joshuathomascarter/MNIST-Accel/docs/figs/carla_town05_junction_demo.png

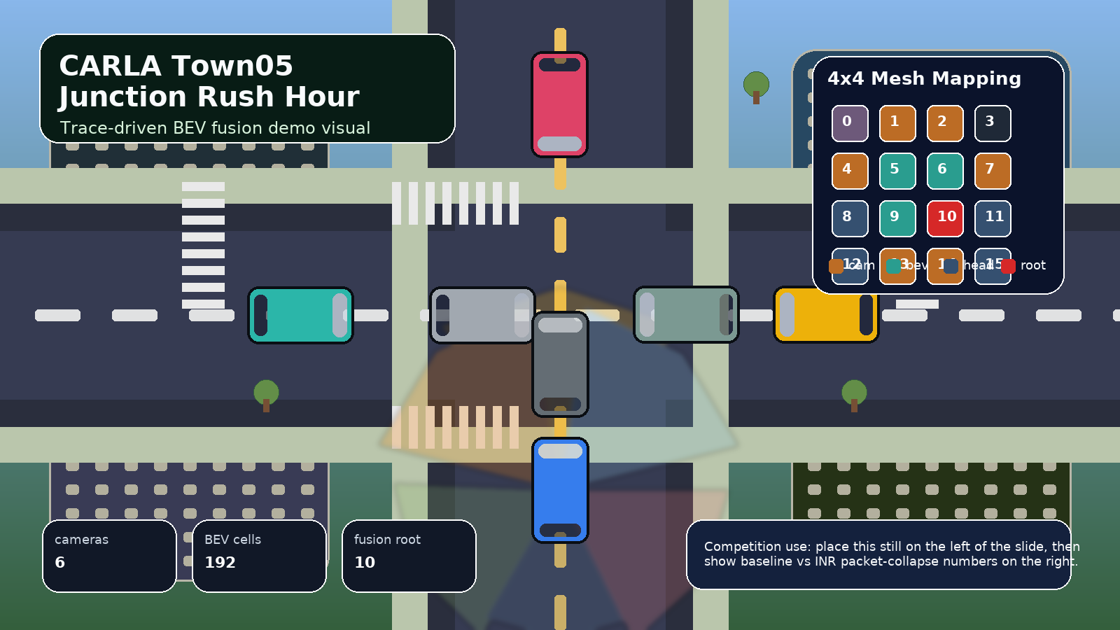
docs/figs/carla_town05_junction_demo.png
