joshuathomascarter/MNIST-Accel/docs/figs/carla_town05_junction_hero.png

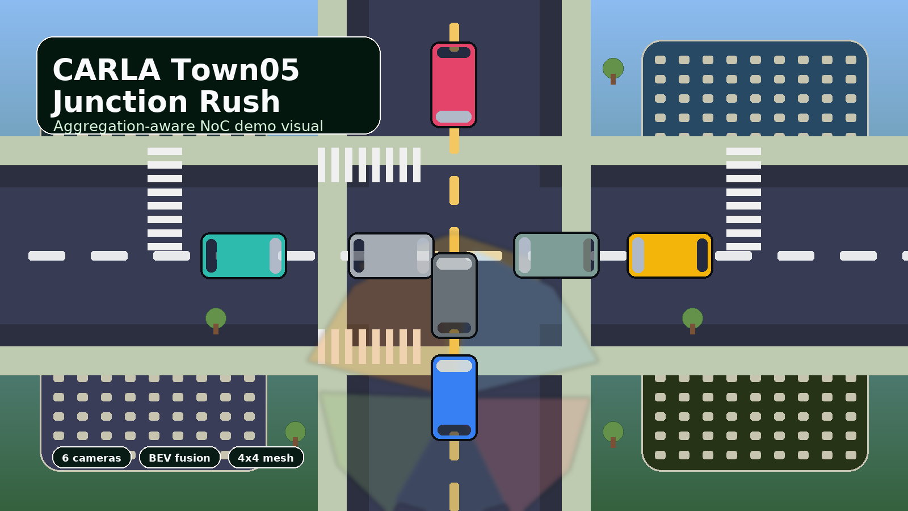
docs/figs/carla_town05_junction_hero.png
