joshuathomascarter/MNIST-Accel/archive/old_project_done/README.md

# Old Project Archive

This directory snapshots the legacy host-side FPGA software stack that is no
longer part of the active `soc_top_v2` bringup path.

## Included

- `sw/ml_python/host/`
- `sw/cpp/include/{driver,memory,compute}/`
- `sw/cpp/src/{driver,memory,compute}/`
- `sw/cpp/apps/{benchmark.cpp,run_mnist_inference.cpp}`

Use this archive as reference only. Active bringup artifacts now live under
`handoff/soc_top_v2/`.
