joshuathomascarter/MNIST-Accel/docs/figs/carla_town05_junction_annotated.png

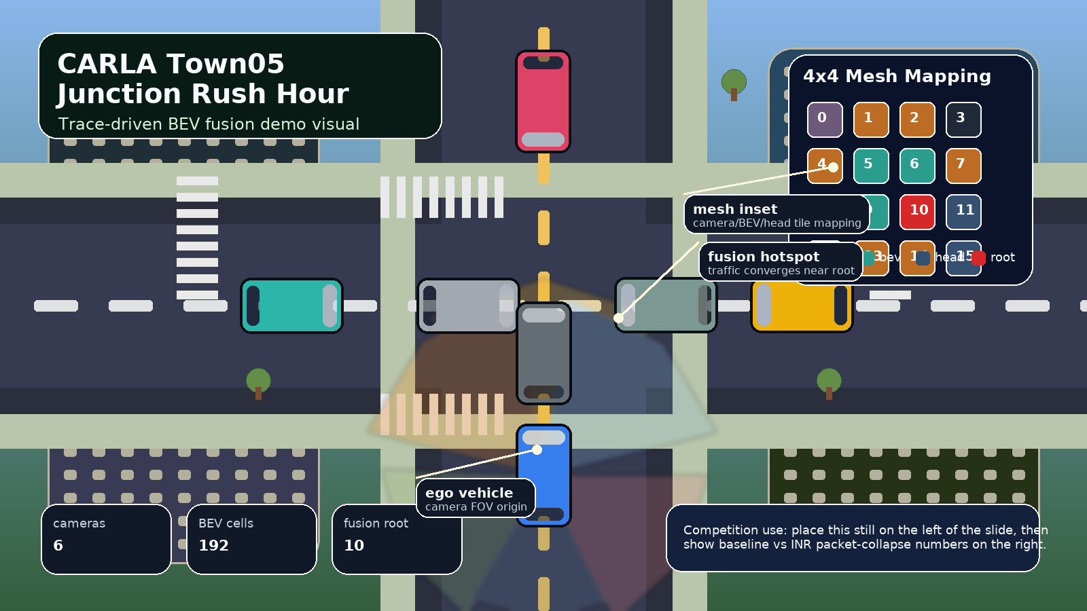
docs/figs/carla_town05_junction_annotated.png
