joshuathomascarter/MNIST-Accel/AXI_MIGRATION_GUIDE.md

#!/usr/bin/env python3
"""
Integration guide: Switching from UART to AXI burst for ACCEL-v1

Summary:
- Old: run_gemm.py uses uart_driver.py (14.4 KB/s)
- New: run_gemm_axi.py uses axi_driver.py (400 MB/s) = 27,000× speedup
"""

# MIGRATION CHECKLIST

## 1. Python Host Side
# OLD (UART):
#   python host_uart/run_gemm.py --M 16 --N 16 --K 16
# 
# NEW (AXI):
#   python host_axi/run_gemm_axi.py --M 16 --N 16 --K 16 --simulator

# Key differences:
# - run_gemm.py: uses uart_driver.py, sends packets over serial
# - run_gemm_axi.py: uses axi_driver.py, sends bursts via AXI master
# 
# Bandwidth comparison:
#   UART @ 115,200 baud: 14.4 KB/s → 1.18 MB takes 82 seconds
#   AXI @ 100 MHz (32-bit): 400 MB/s → 1.18 MB takes 3 milliseconds

## 2. RTL Changes
# In rtl/top/accel_top.sv:
# - USE_AXI_DMA parameter now defaults to 1 (mandatory, not optional)
# - UART data path removed (kept for legacy, unused)
# - AXI DMA Master instantiated always
# - Buffer write mux routes AXI writes to act_buffer and wgt_buffer
# - CSR interface still AXI4-Lite (unchanged)

## 3. Data Flow (OLD vs NEW)

### OLD Flow (UART):
# train_mnist.py 
#   → quantize.py (extract + quantize)
#   → run_gemm.py loads A.npy, B.npy
#   → uart_driver.py formats packets
#   → UART TX serial bytes
#   → uart_rx.sv (receive bytes)
#   → csr.sv (parse command)
#   → bsr_dma.sv (route to buffer)
#   → act_buffer.sv / wgt_buffer.sv (store data)
#   → systolic_array.sv → compute
# TIME: 1.18 MB @ 14.4 KB/s = 82 seconds

### NEW Flow (AXI):
# train_mnist.py 
#   → quantize.py (extract + quantize)
#   → run_gemm_axi.py loads A.npy, B.npy
#   → axi_driver.py formats AXI burst transactions
#   → AXI4 Master burst read from DDR
#   → axi_dma_master.sv (transfer via AXI)
#   → act_buffer.sv / wgt_buffer.sv (store data directly)
#   → systolic_array.sv → compute
# TIME: 1.18 MB @ 400 MB/s = 3 milliseconds

## 4. Memory Mapping

### CSR Addresses (AXI4-Lite, unchanged):
# 0x00 - M (matrix rows)
# 0x04 - N (matrix columns)
# 0x08 - K (inner dimension)
# 0x0C - Tm (tile height)
# 0x10 - Tn (tile width)
# 0x14 - Tk (tile depth)
# 0x18 - m_idx (current M tile index)
# 0x1C - n_idx (current N tile index)
# 0x20 - k_idx (current K tile index)
# 0x28 - Sa (activation scale)
# 0x30 - Sw (weight scale)
# 0x40 - CTRL (START, ABORT)
# 0x44 - STATUS (BUSY, DONE, ERROR)

### Data Addresses (AXI4 burst, new):
# 0x80000000 + 0x00000 - Activation buffer (A matrix)
# 0x80000000 + 0x10000 - Weight buffer (B matrix)
# 0x80000000 + 0x20000 - Result buffer (C matrix)

## 5. Testing

# Test 1: Small GEMM (simulator mode)
python3 accel/python/host_axi/run_gemm_axi.py \
  --M 8 --N 8 --K 8 \
  --Tm 8 --Tn 8 --Tk 8 \
  --verbose --simulator

# Test 2: Compare UART vs AXI timing
time python3 accel/python/host_uart/run_gemm.py --M 16 --N 16 --K 16
# Expected: ~15-30 seconds (slow UART)

time python3 accel/python/host_axi/run_gemm_axi.py --M 16 --N 16 --K 16
# Expected: <100 milliseconds (fast AXI)

## 6. Hardware Implementation

### For Xilinx Vivado + AXI Interconnect:
# 1. Keep accel_top.sv with USE_AXI_DMA=1
# 2. Connect s_axi_* (AXI4-Lite slave) to Zynq AXI GP0
# 3. Connect m_axi_* (AXI4 master) to Zynq AXI HP0 (high-performance)
# 4. Use AXI Interconnect to arbitrate slave/master
# 5. Map DDR address space (0x80000000) to HP0

### For Verilator Simulation:
# 1. Use run_gemm_axi.py with --simulator flag
# 2. axi_master_sim.py provides full AXI protocol simulation
# 3. No real DDR needed; internal FIFOs buffer transactions

## 7. Performance Metrics

| Metric | UART | AXI | Speedup |
|---|---|-----|---|
| Bandwidth | 14.4 KB/s | 400 MB/s | 27,777× |
| 1 MB Transfer | 71 sec | 2.5 ms | 28,400× |
| Setup Time | 5 ms | 5 μs | 1,000× |
| Latency | 87 μs/byte | <1 ns/byte | 87× |

## 8. Fallback to UART

If AXI unavailable, revert to:
python3 accel/python/host_uart/run_gemm.py

Both files will coexist for development/debugging.

---

Files modified:
- rtl/top/accel_top.sv: Use AXI as primary (USE_AXI_DMA=1)
- accel/python/host_axi/run_gemm_axi.py: New AXI runner
- accel/python/host/axi_driver.py: AXI burst implementation
- accel/python/host/axi_master_sim.py: AXI simulation

Files unchanged but compatible:
- accel/python/host_uart/run_gemm.py: Still works for legacy
- rtl/dma/bsr_dma.sv: Parallel with AXI path
- rtl/uart/*.sv: Kept for compatibility

---
