joshuathomascarter/MNIST-Accel/hw/.yosys_soc_top_v2/all/rtl/top/accel_top.sv

// =============================================================================
// accel_top.sv — AXI4-based Sparse INT8 Systolic Array Accelerator Top-Level
// =============================================================================
//
// ARCHITECTURE OVERVIEW:
// ----------------------
// This is the top-level integration module for a sparse INT8 matrix multiply
// accelerator targeting Zynq-7020 (PYNQ-Z2). It implements a weight-stationary
// dataflow with Block Sparse Row (BSR) compression for weight matrices.
//
//   ┌─────────────────────────────────────────────────────────────────────┐
//   │                         Zynq PS (ARM Cortex-A9)                     │
//   │                                                                     │
//   │   Linux Driver                                                      │
//   │       │                                                             │
//   │       ├── AXI-Lite GP0 ─────────────────┐                          │
//   │       │   (CSR R/W)                     │                          │
//   │       │                                 │                          │
//   │       └── mmap DDR ──────────────┐      │                          │
//   │           (Activations, Weights) │      │                          │
//   └───────────────────────────────────┼──────┼──────────────────────────┘
//                                       │      │
//   ┌───────────────────────────────────┼──────┼──────────────────────────┐
//   │                            PL (FPGA Fabric)                         │
//   │                                   │      │                          │
//   │   ┌───────────────────────────────┼──────▼──────┐                  │
//   │   │            AXI Interconnect                 │                  │
//   │   └───────────┬───────────────────┬─────────────┘                  │
//   │               │                   │                                 │
//   │     AXI4 HP0/HP2                 AXI-Lite                          │
//   │     (64-bit DDR)                 (32-bit CSR)                      │
//   │               │                   │                                 │
//   │   ┌───────────▼───────────┐   ┌───▼────────────┐                   │
//   │   │   axi_dma_bridge      │   │ axi_lite_slave │                   │
//   │   │   (2:1 Arbiter)       │   └───────┬────────┘                   │
//   │   └───┬───────────────┬───┘           │                            │
//   │       │               │               │                            │
//   │   ┌───▼───┐       ┌───▼───┐       ┌───▼───┐                        │
//   │   │act_dma│       │bsr_dma│       │  csr  │                        │
//   │   └───┬───┘       └───┬───┘       └───────┘                        │
//   │       │               │                                             │
//   │   ┌───▼───┐       ┌───▼───────────────────┐                        │
//   │   │act_buf│       │ BSR Metadata BRAMs    │                        │
//   │   │ (RAM) │       │ (row_ptr, col_idx,    │                        │
//   │   └───┬───┘       │  wgt_block)           │                        │
//   │       │           └───┬───────────────────┘                        │
//   │       │               │                                             │
//   │       │           ┌───▼────────┐                                   │
//   │       │           │bsr_scheduler│                                    │
//   │       │           └───┬────────┘                                   │
//   │       │               │                                             │
//   │       │     ┌─────────▼─────────┐                                  │
//   │       └────►│ systolic_array    │                                  │
//   │             │ (16×16 PE Grid)   │                                  │
//   │             └─────────┬─────────┘                                  │
//   │                       │                                             │
//   │             ┌─────────▼─────────┐                                  │
//   │             │  Output / Accum   │─────► DMA back to DDR            │
//   │             └───────────────────┘       (future: write DMA)        │
//   │                                                                     │
//   │             ┌───────────────────┐                                  │
//   │             │       perf        │                                  │
//   │             │ (Cycle Counters)  │                                  │
//   │             └───────────────────┘                                  │
//   └─────────────────────────────────────────────────────────────────────┘
//
// DATA FLOW:
// ----------
// 1. Host writes configuration to CSR (matrix dims, DMA addresses)
// 2. Host triggers DMA start pulses:
//    - act_dma: Loads dense activations from DDR → act_buffer RAM
//    - bsr_dma: Loads BSR sparse weights from DDR → metadata BRAMs
// 3. Host triggers start_pulse to begin computation
// 4. bsr_scheduler iterates through non-zero blocks:
//    a. Reads row_ptr[i] and row_ptr[i+1] from BRAM (1-cycle latency)
//    b. For each column index, loads weight block and streams activations
//    c. Signals systolic array with load_weight, pe_en, accum_en
// 5. systolic_array_sparse performs 16×16 MAC operations
// 6. Results accumulate in output registers (visible via CSR)
// 7. done signal asserted when all blocks processed
//
// SPARSE FORMAT (BSR - Block Sparse Row):
// ---------------------------------------
// Memory layout for a matrix with M=32, K=32, block_size=16:
//   DDR Base + 0x00: num_rows (= M/16 = 2)
//   DDR Base + 0x04: num_cols (= K/16 = 2)
//   DDR Base + 0x08: nnz_blocks (number of non-zero 16×16 blocks)
//   DDR Base + 0x0C: block_size (= 16)
//   DDR Base + 0x10: row_ptr[0..num_rows] (32-bit each)
//   DDR Base + 0x10 + (num_rows+1)*4: col_idx[0..nnz_blocks-1] (16-bit each)
//   DDR Base + aligned: blocks[0..nnz_blocks-1] (256 bytes each)
//
// DESIGN CHOICES:
// ---------------
// - SPARSE-ONLY: Dense systolic array variant removed to save ~40% LUT area.
//   For dense layers (fc1, fc2), use 100% dense BSR (no zero blocks).
// - READ-ONLY DMAs: Outputs are read via CSR result registers. Write DMA
//   for large output tensors is a future enhancement.
// - BRAM Sizing: BRAM_ADDR_W=10 gives 1024 entries. With 16×16 blocks:
//   - row_ptr_bram: 1024 × 32-bit = 4 KB (supports up to 1023 block rows)
//   - col_idx_bram: 1024 × 16-bit = 2 KB (supports up to 1024 non-zero blocks)
//   - wgt_block_bram: 1024 × 64-bit = 8 KB (32 full blocks, but typically
//     only current block needs to be resident)
//
// TIMING CONSTRAINTS:
// -------------------
// Target: 100 MHz (10 ns period) on Zynq-7020
// Critical paths:
//   - AXI read data → BRAM write: 3 cycles (DMA FSM latency)
//   - Metadata BRAM read → scheduler: 2 cycles (read-after-write hazard)
//   - Scheduler → systolic array control: 1 cycle
//
// RESOURCE ESTIMATES (Zynq-7020):
// -------------------------------
//   Module            | LUTs  | FFs   | BRAM36 | DSPs
//   ------------------|-------|-------|--------|------
//   axi_lite_slave    |  200  |  150  |   0    |  0
//   csr               |  400  |  500  |   0    |  0
//   axi_dma_bridge    |  300  |  200  |   0    |  0
//   act_dma           |  250  |  180  |   0    |  0
//   bsr_dma           |  450  |  350  |   0    |  0
//   bsr_scheduler     |  350  |  280  |   0    |  0
//   systolic_sparse   | 4000  | 8000  |   0    | 256
//   BRAMs (inline)    |    0  |    0  |   4    |  0
//   perf              |  100  |  200  |   0    |  0
//   ------------------|-------|-------|--------|------
//   Total (approx)    | 6050  | 9850  |   4    | 256
//
// Zynq-7020 has 53,200 LUTs, 106,400 FFs, 140 BRAM36, 220 DSPs.
// This design uses ~12% LUTs, ~10% FFs, ~4% BRAM, ~100% DSPs.
//
// VERIFICATION:
// -------------
// - Cocotb testbench: hw/sim/cocotb/test_accel_top.py
// - C++ testbench: hw/sim/cpp/accel_top_tb.cpp
// - Waveform: Run with +wave=accel_top.vcd
//
// INTEGRATION:
// ------------
// Vivado block design connections:
//   - clk: pl_clk0 (100 MHz from FCLK_CLK0)
//   - rst_n: peripheral_aresetn from proc_sys_reset
//   - m_axi_*: HP0 or HP2 port of Zynq PS
//   - s_axi_*: M_AXI_GP0 through AXI Interconnect
//
// =============================================================================

`timescale 1ns/1ps
`default_nettype none

module accel_top #(
/* verilator lint_off PINCONNECTEMPTY */
    // =========================================================================
    // SYSTOLIC ARRAY PARAMETERS
    // =========================================================================
    // N_ROWS, N_COLS: Systolic array dimensions.
    // - 16×16 systolic array (256 PEs)
    // - Matches BSR block size for efficient weight loading
    parameter N_ROWS     = 16,
    parameter N_COLS     = 16,
    
    // DATA_W: Input data width (INT8 for quantized inference)
    // - INT8 provides 2× throughput vs INT16, 4× vs FP32
    // - Sufficient precision for CNN inference (< 1% accuracy loss)
    parameter DATA_W     = 8,
    
    // ACC_W: Accumulator width to prevent overflow
    // - 8-bit × 8-bit = 16-bit product
    // - Sum of K products: need log2(K) + 16 bits
    // - For K=512 (max), need 16 + 9 = 25 bits minimum
    // - 32 bits provides headroom for larger layers
    parameter ACC_W      = 32,
    
    // =========================================================================
    // AXI INTERFACE PARAMETERS
    // =========================================================================
    // AXI_ADDR_W: 32-bit addresses for Zynq DDR (512 MB - 1 GB range)
    parameter AXI_ADDR_W = 32,
    
    // AXI_DATA_W: 64-bit for HP port bandwidth
    // - Zynq HP ports are 64-bit native
    // - 8 INT8 values per beat × 16 beats = 128 bytes/burst
    parameter AXI_DATA_W = 64,
    
    // AXI_ID_W: Transaction ID for out-of-order completion tracking
    // - 4 bits = 16 outstanding transactions (more than needed)
    // - ID=0 for BSR DMA, ID=1 for Act DMA
    parameter AXI_ID_W   = 4,
    
    // =========================================================================
    // INTERNAL MEMORY PARAMETERS
    // =========================================================================
    // CSR_ADDR_W: 8-bit CSR address (256 registers × 4 bytes = 1 KB)
    // - Matches Vivado AXI peripheral standard address range
    parameter CSR_ADDR_W = 8,
    
    // BRAM_ADDR_W: 10-bit BRAM address (1024 entries)
    // - row_ptr: 1024 × 4B = 4 KB (up to 1023 block rows)
    // - col_idx: 1024 × 2B = 2 KB (up to 1024 non-zero blocks)
    // - wgt_block: 1024 × 8B = 8 KB (block data staging)
    parameter BRAM_ADDR_W = 10
)(
    // =========================================================================
    // Clock & Reset
    // =========================================================================
    // clk: Main system clock (100 MHz from Zynq FCLK_CLK0)
    // - All modules operate on single clock domain
    // - See accel_top_dual_clk.sv for CDC version with separate AXI clock
    input  wire clk,
    
    // rst_n: Active-low synchronous reset
    // - Directly from Zynq proc_sys_reset peripheral_aresetn
    // - Must be held low for at least 16 cycles after clk is stable
    input  wire rst_n,

    // =========================================================================
    // AXI4 Master Interface (Read-Only, To DDR via Zynq HP Port)
    // =========================================================================
    // This interface connects to Zynq HP0 or HP2 for high-bandwidth DDR access.
    // Write channels omitted as this design only reads from DDR.
    // Future: Add write channels for output DMA.
    //
    // Zynq HP Port Capabilities:
    // - 64-bit data width, 1066 MT/s DDR3 → ~4 GB/s per port
    // - Supports outstanding transactions for latency hiding
    // - QoS (Quality of Service) configurable in Vivado
    //
    // -------------------------------------------------------------------------
    // Read Address Channel
    // -------------------------------------------------------------------------
    // m_axi_arid: Transaction ID (ID=0 for BSR DMA, ID=1 for Act DMA)
    // - Allows out-of-order completion if needed (not currently used)
    output wire [AXI_ID_W-1:0]   m_axi_arid,
    
    // m_axi_araddr: Byte address in DDR space (0x0000_0000 - 0x3FFF_FFFF)
    // - Must be aligned to transfer size (8-byte for 64-bit)
    output wire [AXI_ADDR_W-1:0] m_axi_araddr,
    
    // m_axi_arlen: Burst length - 1 (0 = 1 beat, 15 = 16 beats)
    // - 16 beats × 8 bytes = 128 bytes per burst (optimal for DDR)
    output wire [7:0]            m_axi_arlen,
    
    // m_axi_arsize: Bytes per beat = 2^arsize (3'b011 = 8 bytes)
    output wire [2:0]            m_axi_arsize,
    
    // m_axi_arburst: Burst type (2'b01 = INCR, incrementing addresses)
    output wire [1:0]            m_axi_arburst,
    
    // m_axi_arvalid/arready: Standard AXI handshake
    output wire                  m_axi_arvalid,
    input  wire                  m_axi_arready,

    // -------------------------------------------------------------------------
    // Read Data Channel
    // -------------------------------------------------------------------------
    // m_axi_rid: Echoed transaction ID (matches arid for request tracking)
    input  wire [AXI_ID_W-1:0]   m_axi_rid,
    
    // m_axi_rdata: 64-bit read data from DDR
    // - Contains 8 INT8 values or metadata (row_ptr, col_idx)
    input  wire [AXI_DATA_W-1:0] m_axi_rdata,
    
    // m_axi_rresp: Read response (2'b00 = OKAY, 2'b10 = SLVERR)
    input  wire [1:0]            m_axi_rresp,
    
    // m_axi_rlast: Last beat of burst (asserted on final transfer)
    input  wire                  m_axi_rlast,
    
    // m_axi_rvalid/rready: Data channel handshake
    input  wire                  m_axi_rvalid,
    output wire                  m_axi_rready,

    // =========================================================================
    // AXI4 Master Write Interface (Output DMA → DDR via Zynq HP Port)
    // =========================================================================
    // Separate from read channels — AXI4 supports full-duplex read/write.
    // Only one write master (out_dma), so no arbitration needed.
    //
    // -------------------------------------------------------------------------
    // Write Address Channel
    // -------------------------------------------------------------------------
    output wire [AXI_ID_W-1:0]   m_axi_awid,
    output wire [AXI_ADDR_W-1:0] m_axi_awaddr,
    output wire [7:0]            m_axi_awlen,
    output wire [2:0]            m_axi_awsize,
    output wire [1:0]            m_axi_awburst,
    output wire                  m_axi_awvalid,
    input  wire                  m_axi_awready,

    // -------------------------------------------------------------------------
    // Write Data Channel
    // -------------------------------------------------------------------------
    output wire [AXI_DATA_W-1:0] m_axi_wdata,
    output wire [AXI_DATA_W/8-1:0] m_axi_wstrb,
    output wire                  m_axi_wlast,
    output wire                  m_axi_wvalid,
    input  wire                  m_axi_wready,

    // -------------------------------------------------------------------------
    // Write Response Channel
    // -------------------------------------------------------------------------
    input  wire [AXI_ID_W-1:0]   m_axi_bid,
    input  wire [1:0]            m_axi_bresp,
    input  wire                  m_axi_bvalid,
    output wire                  m_axi_bready,

    // =========================================================================
    // AXI4-Lite Slave Interface (CSR from Zynq GP Port)
    // =========================================================================
    // This interface connects to Zynq M_AXI_GP0 through an AXI Interconnect.
    // Provides register access for configuration, control, and status.
    //
    // GP Port Characteristics:
    // - 32-bit data width
    // - Lower bandwidth than HP (suitable for control registers)
    // - Directly accessible from Linux via /dev/mem or UIO driver
    //
    // Address Map (byte addresses, CSR base typically 0x4000_0000):
    //   0x00: CTRL      - Start/abort control
    //   0x04: STATUS    - Busy/done/error flags
    //   0x10-0x1C: Matrix dimensions (M, N, K)
    //   0x40-0x4C: DMA addresses and lengths
    //   0x80-0xBC: Performance counters (read-only)
    //   0xC0-0xFC: Result data (first 16 accumulators)
    //
    // -------------------------------------------------------------------------
    // Write Address Channel
    input  wire [AXI_ADDR_W-1:0] s_axi_awaddr,
    input  wire [2:0]            s_axi_awprot,   // Protection (ignored)
    input  wire                  s_axi_awvalid,
    output wire                  s_axi_awready,
    
    // Write Data Channel
    input  wire [31:0]           s_axi_wdata,
    input  wire [3:0]            s_axi_wstrb,    // Byte strobes (all 1s for word writes)
    input  wire                  s_axi_wvalid,
    output wire                  s_axi_wready,
    
    // Write Response Channel
    output wire [1:0]            s_axi_bresp,    // Always OKAY
    output wire                  s_axi_bvalid,
    input  wire                  s_axi_bready,
    
    // Read Address Channel
    input  wire [AXI_ADDR_W-1:0] s_axi_araddr,
    input  wire [2:0]            s_axi_arprot,   // Protection (ignored)
    input  wire                  s_axi_arvalid,
    output wire                  s_axi_arready,
    
    // Read Data Channel
    output wire [31:0]           s_axi_rdata,
    output wire [1:0]            s_axi_rresp,    // Always OKAY
    output wire                  s_axi_rvalid,
    input  wire                  s_axi_rready,

    // =========================================================================
    // Status Outputs (directly from CSR control signals)
    // =========================================================================
    // These signals can be routed to LEDs or external pins for debugging.
    // Also readable via CSR STATUS register.
    //
    // busy: Accelerator is processing (act_dma_busy | bsr_dma_busy | sched_busy)
    output wire busy,
    
    // done: Computation complete (tile/layer finished)
    output wire done,
    
    // error: DMA or AXI error occurred (address fault, bus error)
    output wire error,

    // irq: Active-high interrupt to Zynq PS (active when done && irq_en)
    // Connect to IRQ_F2P[0] on Zynq PS for interrupt-driven completion
    output wire irq
);

    // =========================================================================
    // Internal Signal Declarations
    // =========================================================================
    // Signal naming convention:
    //   - cfg_*: Configuration values from CSR
    //   - *_dma_*: DMA control/status signals
    //   - *_we, *_waddr, *_wdata: BRAM write interface
    //   - *_rd_*, *_rdata: BRAM read interface
    //   - sched_*: Scheduler control signals
    //   - meta_*: Metadata decoder interface

    // -------------------------------------------------------------------------
    // CSR Interface Signals
    // -------------------------------------------------------------------------
    // CSR bus signals (from axi_lite_slave to csr module)
    wire                    csr_wen, csr_ren;
    wire [CSR_ADDR_W-1:0]   csr_addr;
    wire [31:0]             csr_wdata, csr_rdata;
    
    // Control pulses (W1P - Write-1-Pulse, self-clearing)
    wire                    start_pulse;    // Triggers computation start
    wire                    abort_pulse;    // Emergency stop (clears all state)

    // CSR Configuration Outputs (directly from register values)
    wire [31:0] cfg_act_src_addr;           // Activation DMA source address
    wire [31:0] cfg_bsr_src_addr;           // BSR DMA source address
    wire [31:0] cfg_act_xfer_len;           // Activation transfer length (bytes)
    wire        cfg_act_dma_start;          // Activation DMA start pulse
    wire [31:0] cfg_bsr_num_blocks;         // BSR non-zero blocks
    wire [31:0] cfg_bsr_block_rows;         // BSR block rows (M/14)
    wire [31:0] cfg_bsr_block_cols;         // BSR block cols (K/14)

    // -------------------------------------------------------------------------
    // DMA Control Signals
    // -------------------------------------------------------------------------
    // Activation DMA (loads dense activation vectors from DDR)
    // - Transfers contiguous data from cfg_act_src_addr
    // - Writes to act_buffer RAM
    wire                    act_dma_start;      // Start pulse (from CSR)
    wire                    act_dma_done;       // Transfer complete
    wire                    act_dma_busy;       // Transfer in progress
    wire                    act_dma_error;      // Bus error or timeout
    wire [AXI_ADDR_W-1:0]   act_dma_src_addr;   // DDR source address
    wire [31:0]             act_dma_xfer_len;   // Bytes to transfer

    // BSR DMA (loads sparse weight structure from DDR)
    // - Parses BSR header, row_ptr, col_idx, and weight blocks
    // - Writes to respective BRAM banks
    wire                    bsr_dma_start;      // Start pulse (from CSR)
    wire                    bsr_dma_done;       // All phases complete
    wire                    bsr_dma_busy;       // Any phase in progress
    wire                    bsr_dma_error;      // Parse error or bus error
    wire [AXI_ADDR_W-1:0]   bsr_dma_src_addr;   // DDR base address of BSR data

    // -------------------------------------------------------------------------
    // AXI DMA Bridge Internal Signals (2:1 Arbiter between two DMAs)
    // -------------------------------------------------------------------------
    // The bridge arbitrates between act_dma (slave 1) and bsr_dma (slave 0)
    // to share a single AXI4 master port. Round-robin with priority to
    // bsr_dma (s0) since weight loading is typically on critical path.
    //
    // Signal naming: {module}_{channel}{signal}
    //   - act_ar*: Activation DMA read address channel
    //   - act_r*:  Activation DMA read data channel
    //   - bsr_ar*: BSR DMA read address channel
    //   - bsr_r*:  BSR DMA read data channel
    //
    // act_dma → Bridge (Slave 1, lower priority)
    wire [AXI_ID_W-1:0]     act_arid;
    wire [AXI_ADDR_W-1:0]   act_araddr;
    wire [7:0]              act_arlen;
    wire [2:0]              act_arsize;
    wire [1:0]              act_arburst;
    wire                    act_arvalid;
    wire                    act_arready;
    wire [AXI_ID_W-1:0]     act_rid;
    wire [AXI_DATA_W-1:0]   act_rdata;
    wire [1:0]              act_rresp;
    wire                    act_rlast;
    wire                    act_rvalid;
    wire                    act_rready;

    // bsr_dma → Bridge (Slave 0)
    wire [AXI_ID_W-1:0]     bsr_arid;
    wire [AXI_ADDR_W-1:0]   bsr_araddr;
    wire [7:0]              bsr_arlen;
    wire [2:0]              bsr_arsize;
    wire [1:0]              bsr_arburst;
    wire                    bsr_arvalid;
    wire                    bsr_arready;
    wire [AXI_ID_W-1:0]     bsr_rid;
    wire [AXI_DATA_W-1:0]   bsr_rdata;
    wire [1:0]              bsr_rresp;
    wire                    bsr_rlast;
    wire                    bsr_rvalid;
    wire                    bsr_rready;

    // -------------------------------------------------------------------------
    // Buffer Write Interfaces (from DMAs → BRAMs)
    // -------------------------------------------------------------------------
    // These interfaces connect DMA outputs to BRAM write ports.
    // All writes are single-cycle, no back-pressure needed.
    
    // Activation Buffer Write (from act_dma → act_buffer_ram)
    // - 64-bit writes, address incremented by 8 per beat
    wire                    act_buf_we;         // Write enable
    wire [AXI_ADDR_W-1:0]   _unused_act_waddr;  // DMA address (packer generates its own)
    wire [AXI_DATA_W-1:0]   act_buf_wdata;      // 8 INT8 values

    // BSR Row Pointer Write (from bsr_dma → row_ptr_bram)
    // - 32-bit entries, one per block row + 1 (CSR format)
    // - Value at row_ptr[i] is index of first non-zero block in row i
    wire                    row_ptr_we;
    wire [BRAM_ADDR_W-1:0]  row_ptr_waddr;      // Entry index (not byte addr)
    wire [31:0]             row_ptr_wdata;      // Block index

    // BSR Column Index Write (from bsr_dma → col_idx_bram)
    // - 16-bit entries, one per non-zero block
    // - Value is column index of the block in original matrix
    wire                    col_idx_we;
    wire [BRAM_ADDR_W-1:0]  col_idx_waddr;      // Entry index
    wire [15:0]             col_idx_wdata;      // Column block index

    // Weight Block Write (from bsr_dma → wgt_block_bram)
    // - 64-bit writes (8 INT8 weights per beat)
    // - Address includes block index and intra-block offset
    // - BRAM_ADDR_W+6:0 = 17 bits: [16:7] block index, [6:0] intra-block offset
    wire                    wgt_we;
    wire [BRAM_ADDR_W+6:0]  _unused_wgt_waddr;  // DMA address (packer generates its own)
    wire [63:0]             wgt_wdata;          // 8 INT8 weights

    // -------------------------------------------------------------------------
    // Metadata SRAM Read Wires (Scheduler → wrappers, no meta decoder)
    // -------------------------------------------------------------------------
    // Scheduler drives explicit read-enable/address signals into synchronous
    // 1RW SRAM wrappers for the BSR metadata tables.
    wire                    sched_row_ptr_rd_en;
    wire [BRAM_ADDR_W-1:0]  sched_row_ptr_addr;  // row_ptr read address
    wire [31:0]             sched_row_ptr_data;  // row_ptr read data
    wire                    sched_col_idx_rd_en;
    wire [BRAM_ADDR_W-1:0]  sched_col_idx_addr;  // col_idx read address
    wire [15:0]             sched_col_idx_data;  // col_idx read data

    // -------------------------------------------------------------------------
    // Scheduler Interface (BSR-only)
    // -------------------------------------------------------------------------
    // The BSR scheduler generates control signals for the systolic array.
    // Weight-stationary dataflow:
    // 1. Load weight block → 2. Stream activations → 3. Accumulate → 4. Next block
    //
    wire                    sched_start;        // Start traversal (from CSR)
    wire                    sched_busy;         // Traversal in progress
    wire                    sched_done;         // All blocks processed
    
    // Tiled dimensions (block counts, not element counts)
    // MT = M / BLOCK_SIZE = number of output tile rows
    // KT = K / BLOCK_SIZE = number of weight tile columns
    wire [9:0]              sched_MT;           // Tile rows (max 1023)
    wire [11:0]             sched_KT;           // Tile columns (max 4095)

    // -------------------------------------------------------------------------
    // BSR Scheduler Outputs (BSR-only, dense scheduler removed)
    // -------------------------------------------------------------------------
    wire                    load_weight;        // Load weights into PE registers
    wire                    pe_en;              // Enable MAC operations (block_valid)
    wire                    pe_clr;             // Clear PE accumulators (on abort)
    wire [AXI_ADDR_W-1:0]   wgt_rd_addr;        // Weight buffer read address
    wire                    act_rd_en;          // Activation buffer read enable
    wire [AXI_ADDR_W-1:0]   act_rd_addr;        // Activation buffer read address
    wire                    _unused_wgt_rd_en;  // Weight read-enable (unused in BSR)
    wire                    _unused_accum_en;   // Accumulate enable (unused in BSR)

    // -------------------------------------------------------------------------
    // Activation Buffer Read Interface
    // -------------------------------------------------------------------------
    // Returns N_ROWS INT8 values (16 bytes = 128 bits) per read
    // - Packed as {a[13], a[12], ..., a[1], a[0]} (LSB = row 0)
    // - Fed to systolic array a_in_flat port
    wire [N_ROWS*DATA_W-1:0] act_rd_data;       // 128 bits for 16×8

    // -------------------------------------------------------------------------
    // Weight Buffer (Block Data) Read Interface
    // -------------------------------------------------------------------------
    // Returns N_COLS INT8 values (16 bytes = 128 bits) per read
    // - One row of a 16×16 weight block
    // - Fed to systolic array b_in_flat port
    wire [N_COLS*DATA_W-1:0] wgt_rd_data;       // 128 bits for 16×8

    // -------------------------------------------------------------------------
    // Sparse Systolic Array Interface
    // -------------------------------------------------------------------------
    // Output: N_ROWS × N_COLS accumulators, each ACC_W bits (32-bit)
    // - Total: 16 × 16 × 32 = 8192 bits
    // - Flattened as [row0_col0, row0_col1, ..., row15_col15]
    // - First 4 accumulators (128 bits) exposed via CSR for quick readout
    wire [N_ROWS*N_COLS*ACC_W-1:0] systolic_out_flat;  // 8192 bits

    // -------------------------------------------------------------------------
    // Performance Counters
    // -------------------------------------------------------------------------
    // These counters measure execution performance for profiling.
    // All counters are 32-bit, wrapping at ~43 seconds @ 100 MHz.
    wire [31:0] perf_total_cycles;      // Cycles from start to done
    wire [31:0] perf_active_cycles;     // Cycles with pe_en=1
    wire [31:0] perf_idle_cycles;       // Cycles waiting for data
    wire [31:0] perf_dma_bytes;         // Total bytes transferred by both DMAs
    wire [31:0] perf_blocks_processed;  // BSR non-zero blocks computed
    wire [31:0] perf_stall_cycles;      // Cycles scheduler busy but PE idle

    // -------------------------------------------------------------------------
    // Output Accumulator Interface
    // -------------------------------------------------------------------------
    // Captures systolic array results at end of each block row,
    // applies ReLU + INT32→INT8 quantization, and provides DMA readout.
    // Output DMA
    wire        out_dma_done;           // Output written to DDR
    wire        out_dma_busy;           // Output DMA in progress
    wire [31:0] cfg_dma_dst_addr;       // DDR destination for output

    // Output Accumulator
    wire        accum_busy;             // Accumulation in progress
    wire        accum_bank_sel;         // Current active bank
    wire [31:0] cfg_sa_bits;            // Quantization scale from CSR (Q16.16)

    // Output Accumulator ↔ Output DMA wiring
    wire        out_dma_rd_en;
    wire [BRAM_ADDR_W-1:0] out_dma_rd_addr;
    wire [63:0] out_dma_rd_data;
    wire        out_dma_ready;
    wire [31:0] _unused_accum_debug;      // Debug accumulator (unused in prod)
    wire        _unused_perf_done;        // Perf measurement-done (read via CSR)

    // -------------------------------------------------------------------------
    // Multi-Layer Pipeline Signals
    // -------------------------------------------------------------------------
    // Layer configuration (from CSR)
    wire [7:0]  cfg_layer_total;
    wire [7:0]  cfg_layer_current;
    wire        cfg_pool_en;
    wire [15:0] cfg_output_h;
    wire [15:0] cfg_output_w;

    // Output BRAM Controller signals
    wire        obram_ctrl_accum_rd_en;
    wire [BRAM_ADDR_W-1:0] obram_ctrl_accum_rd_addr;
    wire        obram_ctrl_bram_wr_en;
    wire [BRAM_ADDR_W-1:0] obram_ctrl_bram_wr_addr;
    wire [63:0] obram_ctrl_bram_wr_data;
    wire        obram_ctrl_bank_sel;
    wire        obram_ctrl_bram_rd_en;
    wire [BRAM_ADDR_W-1:0] obram_ctrl_bram_rd_addr;
    wire [63:0] obram_bram_rd_data;
    wire        obram_bram_rd_valid;
    wire        obram_ctrl_fb_we;
    wire [BRAM_ADDR_W-1:0] obram_ctrl_fb_waddr;
    wire [N_ROWS*DATA_W-1:0] obram_ctrl_fb_wdata;
    wire        obram_ctrl_out_dma_trigger;
    wire        obram_ctrl_layer_done;
    wire        obram_ctrl_last_layer_done;
    wire        obram_ctrl_feedback_busy;
    wire        obram_ctrl_busy;

    // Max-pooling signals (between output_bram_ctrl writes and actual BRAM writes)
    wire        pool_out_valid;
    wire [63:0] pool_out_data;
    wire        pool_in_ready;

    // Post-pooler BRAM write address counter
    reg [BRAM_ADDR_W-1:0] pool_bram_wr_addr;

    // Accumulator read MUX: output_bram_ctrl owns the accumulator read port.
    // out_dma reads from BRAM (not accumulator) on last layer.
    wire        mux_accum_rd_en;
    wire [BRAM_ADDR_W-1:0] mux_accum_rd_addr;

    assign mux_accum_rd_en   = obram_ctrl_accum_rd_en;
    assign mux_accum_rd_addr = obram_ctrl_accum_rd_addr;

    // Feedback MUX: act_buffer write source (act_dma vs feedback)
    wire        fb_mux_act_we;
    wire [BRAM_ADDR_W-1:0] fb_mux_act_waddr;
    wire [N_ROWS*DATA_W-1:0] fb_mux_act_wdata;

    // Row completion detection for BSR mode
    // PEs have clr hardwired to 0 — accumulators persist across all blocks.
    // The full result is available only when sched_done fires.
    // row_complete_d1 provides a 1-cycle delayed clear pulse.
    wire        row_complete;
    reg         row_complete_d1;        // Delayed clear pulse

    // -------------------------------------------------------------------------
    // Status Aggregation
    // -------------------------------------------------------------------------
    // Combine status from all modules for top-level outputs
    // - busy: Any module is actively processing
    // - done: Scheduler has finished all blocks
    // - error: Any DMA reported an error (address fault, bus error, etc.)
    assign busy  = act_dma_busy | bsr_dma_busy | sched_busy | accum_busy | out_dma_busy | obram_ctrl_busy;
    assign done  = obram_ctrl_last_layer_done | (out_dma_done & ~obram_ctrl_busy);
    assign error = bsr_dma_error | act_dma_error | axi_error;

    // Interrupt: assert when computation completes and interrupts are enabled
    wire        axi_error;              // AXI-Lite protocol error (from slave)
    wire        irq_en;                 // Interrupt enable (from CSR)
    assign irq = done & irq_en;

    // -------------------------------------------------------------------------
    // Intentionally-Unused Signal Aggregation
    // -------------------------------------------------------------------------
    // Wires prefixed with "_unused" suppress UNUSEDSIGNAL lint warnings.
    // Partial-width unused bits are collected here.
    //
    // s_axi_a[wr]addr upper bits: AXI spec requires 32-bit addresses but
    //   CSR space only uses [CSR_ADDR_W-1:0] = 8 bits.
    // cfg_bsr_config: only bit [1] (relu_en) is used; bits [31:2] and [0]
    //   are reserved for future features.
    // wgt_rd_addr / act_rd_addr: scheduler outputs 32-bit addresses but
    //   BRAMs only use [BRAM_ADDR_W-1:0] = 10 bits.
    // cfg_bsr_block_cols[31:12]: scheduler KT uses only 12 bits (max 4096
    //   tile columns); upper CSR bits are for software readback only.
    wire _unused_addr_bits = &{1'b0,
        s_axi_awaddr[AXI_ADDR_W-1:CSR_ADDR_W],
        s_axi_araddr[AXI_ADDR_W-1:CSR_ADDR_W],
        cfg_bsr_config[31:2], cfg_bsr_config[0],
        cfg_bsr_block_cols[31:12],
        wgt_rd_addr[AXI_ADDR_W-1:BRAM_ADDR_W],
        act_rd_addr[AXI_ADDR_W-1:BRAM_ADDR_W]
    };

    // =========================================================================
    // Module Instantiations
    // =========================================================================
    // Instantiation order follows data flow:
    // 1. AXI interfaces (entry points)
    // 2. Control (CSR)
    // 3. DMA bridge (AXI arbitration)
    // 4. DMAs (data movement)
    // 5. Storage (BRAMs)
    // 6. Decode/Schedule (control flow)
    // 7. Compute (systolic array)
    // 8. Monitoring (performance)

    // -------------------------------------------------------------------------
    // 1. AXI4-Lite Slave (CSR Access from Host CPU)
    // -------------------------------------------------------------------------
    // Converts AXI4-Lite transactions to simple register read/write interface.
    // Handles AXI protocol (ready/valid handshakes, write response).
    //
    // Timing:
    //   - Write: 2 cycles (awvalid + wvalid → bvalid)
    //   - Read: 2 cycles (arvalid → rvalid)
    //
    // Note: Address is truncated to CSR_ADDR_W bits. Host driver must ensure
    // accesses are within the configured address range.
    axi_lite_slave #(
        .CSR_ADDR_WIDTH(CSR_ADDR_W),
        .CSR_DATA_WIDTH(32)
    ) u_axi_lite_slave (
        .clk            (clk),
        .rst_n          (rst_n),
        // AXI4-Lite Write
        .s_axi_awaddr   (s_axi_awaddr[CSR_ADDR_W-1:0]),
        .s_axi_awprot   (s_axi_awprot),
        .s_axi_awvalid  (s_axi_awvalid),
        .s_axi_awready  (s_axi_awready),
        .s_axi_wdata    (s_axi_wdata),
        .s_axi_wstrb    (s_axi_wstrb),
        .s_axi_wvalid   (s_axi_wvalid),
        .s_axi_wready   (s_axi_wready),
        .s_axi_bresp    (s_axi_bresp),
        .s_axi_bvalid   (s_axi_bvalid),
        .s_axi_bready   (s_axi_bready),
        // AXI4-Lite Read
        .s_axi_araddr   (s_axi_araddr[CSR_ADDR_W-1:0]),
        .s_axi_arprot   (s_axi_arprot),
        .s_axi_arvalid  (s_axi_arvalid),
        .s_axi_arready  (s_axi_arready),
        .s_axi_rdata    (s_axi_rdata),
        .s_axi_rresp    (s_axi_rresp),
        .s_axi_rvalid   (s_axi_rvalid),
        .s_axi_rready   (s_axi_rready),
        // CSR Interface
        .csr_addr       (csr_addr),
        .csr_wen        (csr_wen),
        .csr_ren        (csr_ren),
        .csr_wdata      (csr_wdata),
        .csr_rdata      (csr_rdata),
        .axi_error      (axi_error)
    );

    // -------------------------------------------------------------------------
    // Software-Only CSR Registers (not consumed by hardware datapath)
    // -------------------------------------------------------------------------
    // The CSR module provides these outputs because the host writes and reads
    // them for its own configuration tracking. The BSR-only hardware datapath
    // does NOT consume them for the following architectural reasons:
    //
    //   cfg_M/N/K:  Host provides raw matrix dimensions for software QA.
    //               Hardware uses MT/KT (block counts from bsr_block_rows/cols).
    //   Tm/Tn/Tk:   Dense-mode tile sizes. BSR scheduler generates its own.
    //   m/n/k_idx:  Dense-mode tile loop counters. BSR iterates row_ptr.
    //   bank_sel_*: Double-buffer selection. Output accumulator
    //               manages bank_sel internally.
    //   Sw_bits:    Weight quantization scale. Host pre-combines Sa*Sw into
    //               Sa_bits so hardware only needs one scale factor.
    //   dma_dst_addr/xfer_len: For future write-DMA (output to DDR).
    //               Currently results are read via CSR result_data registers.
    //   bsr_ptr/idx_addr: Separate DDR addresses for BSR sub-arrays.
    //               bsr_dma reads the entire BSR structure sequentially from
    //               one base address, so split addressing is not used.
    //
    // Prefixed _unused so Verilator suppresses UNUSEDSIGNAL lint.
    wire [31:0] _unused_cfg_M, _unused_cfg_N, _unused_cfg_K;
    wire [31:0] _unused_Tm, _unused_Tn, _unused_Tk;
    wire [31:0] _unused_m_idx, _unused_n_idx, _unused_k_idx;
    wire        _unused_bank_sel_wr_A, _unused_bank_sel_wr_B;
    wire        _unused_bank_sel_rd_A, _unused_bank_sel_rd_B;
    wire [31:0] _unused_Sw_bits;
    wire [31:0] _unused_dma_xfer_len;
    wire [31:0] _unused_bsr_ptr_addr, _unused_bsr_idx_addr;

    // -------------------------------------------------------------------------
    // 2. CSR Module (Configuration & Control Registers)
    // -------------------------------------------------------------------------
    // Central register bank for accelerator configuration and status.
    // See csr.sv for full address map documentation.
    //
    // Key Registers:
    //   - CTRL (0x00): Start/abort control (W1P bits)
    //   - STATUS (0x04): Busy/done/error flags (RO)
    //   - M/N/K (0x10-0x18): Matrix dimensions
    //   - DMA_SRC_ADDR (0x40): BSR data base address
    //   - ACT_SRC_ADDR (0x48): Activation data base address
    //   - PERF_* (0x80+): Performance counters
    //
    // Unused outputs are left unconnected for future features.
    csr #(
        .ADDR_W(CSR_ADDR_W)
    ) u_csr (
        .clk                    (clk),
        .rst_n                  (rst_n),
        // CSR Bus
        .csr_wen                (csr_wen),
        .csr_ren                (csr_ren),
        .csr_addr               (csr_addr),
        .csr_wdata              (csr_wdata),
        .csr_rdata              (csr_rdata),
        // Status Inputs
        .core_busy              (busy),
        .core_done_tile_pulse   (sched_done),
        .core_bank_sel_rd_A     (accum_bank_sel),
        .core_bank_sel_rd_B     (1'b0),
        .rx_illegal_cmd         (1'b0),  // Tied off — error detection via CSR STATUS
        // Control Outputs
        .start_pulse            (start_pulse),
        .abort_pulse            (abort_pulse),
        .irq_en                 (irq_en),
        // Matrix Dimensions
        .M                      (_unused_cfg_M),
        .N                      (_unused_cfg_N),
        .K                      (_unused_cfg_K),
        // Tile Sizes (not used in sparse mode, but kept for compatibility)
        .Tm                     (_unused_Tm),
        .Tn                     (_unused_Tn),
        .Tk                     (_unused_Tk),
        .m_idx                  (_unused_m_idx),
        .n_idx                  (_unused_n_idx),
        .k_idx                  (_unused_k_idx),
        // Bank Selection (unused in BSR sparse mode)
        .bank_sel_wr_A          (_unused_bank_sel_wr_A),
        .bank_sel_wr_B          (_unused_bank_sel_wr_B),
        .bank_sel_rd_A          (_unused_bank_sel_rd_A),
        .bank_sel_rd_B          (_unused_bank_sel_rd_B),
        // Scaling Factors (for quantization)
        .Sa_bits                (cfg_sa_bits),
        .Sw_bits                (_unused_Sw_bits),
        // Performance Counters
        .perf_total_cycles      (perf_total_cycles),
        .perf_active_cycles     (perf_active_cycles),
        .perf_idle_cycles       (perf_idle_cycles),
        .perf_dma_bytes         (perf_dma_bytes),
        .perf_blocks_processed  (perf_blocks_processed),
        .perf_stall_cycles      (perf_stall_cycles),
        // Result Data (first 4 accumulators for quick read)
        .result_data            (systolic_out_flat[127:0]),
        // DMA Control/Status
        .dma_busy_in            (act_dma_busy | bsr_dma_busy),
        .dma_done_in            (act_dma_done & bsr_dma_done),
        .dma_bytes_xferred_in   (perf_dma_bytes),
        .dma_src_addr           (cfg_bsr_src_addr),
        .dma_dst_addr           (cfg_dma_dst_addr),
        .dma_xfer_len           (_unused_dma_xfer_len),
        .dma_start_pulse        (bsr_dma_start),
        // Activation DMA
        .act_dma_src_addr       (cfg_act_src_addr),
        .act_dma_len            (cfg_act_xfer_len),
        .act_dma_start_pulse    (cfg_act_dma_start),
        // BSR Control
        .bsr_config             (cfg_bsr_config),
        .bsr_num_blocks         (cfg_bsr_num_blocks),
        .bsr_block_rows         (cfg_bsr_block_rows),
        .bsr_block_cols         (cfg_bsr_block_cols),
        .bsr_ptr_addr           (_unused_bsr_ptr_addr),
        .bsr_idx_addr           (_unused_bsr_idx_addr),
        // Layer management
        .layer_total            (cfg_layer_total),
        .layer_current          (cfg_layer_current),
        .pool_en                (cfg_pool_en),
        .output_h               (cfg_output_h),
        .output_w               (cfg_output_w),
        .layer_done_in          (obram_ctrl_layer_done),
        .last_layer_done_in     (obram_ctrl_last_layer_done)
    );

    // BSR config register (sched_mode removed — BSR-only architecture)
    wire [31:0] cfg_bsr_config;

    // -------------------------------------------------------------------------
    // CSR → DMA/Scheduler Signal Routing
    // -------------------------------------------------------------------------
    // Route CSR outputs to the appropriate modules. These are direct
    // combinational connections (no pipelining).
    
    // BSR DMA source address (base of BSR structure in DDR)
    assign bsr_dma_src_addr = cfg_bsr_src_addr;
    // Activation DMA control signals
    assign act_dma_start    = cfg_act_dma_start;
    assign act_dma_src_addr = cfg_act_src_addr;
    assign act_dma_xfer_len = cfg_act_xfer_len;

    // Scheduler control signals
    // - sched_start: Single-cycle pulse to begin BSR traversal
    // - sched_MT: Block rows = M / BLOCK_SIZE
    // - sched_KT: Block cols = K / BLOCK_SIZE
    // These are now pre-computed by the driver and provided via CSR.
    assign sched_start = start_pulse;
    assign sched_MT    = cfg_bsr_block_rows[9:0];
    assign sched_KT    = cfg_bsr_block_cols[11:0];

    // -------------------------------------------------------------------------
    // 3. AXI DMA Bridge (Arbitrates act_dma and bsr_dma to single AXI Master)
    // -------------------------------------------------------------------------
    // Two-slave AXI4 read arbiter. Multiplexes read address and data channels
    // from act_dma (s1) and bsr_dma (s0) to a single master port.
    //
    // Arbitration Policy:
    //   - Round-robin when both requesting
    //   - s0 (bsr_dma) has slight priority (checked first)
    //
    // ID Routing:
    //   - s0 transactions use ID bit [0] = 0
    //   - s1 transactions use ID bit [0] = 1
    //   - Allows routing responses back to correct slave
    //
    // Bandwidth Considerations:
    //   - HP port: ~2 GB/s effective bandwidth
    //   - Two DMAs rarely contend (different phases of operation)
    //   - bsr_dma runs first (load weights), then act_dma (stream activations)
    axi_dma_bridge #(
        .DATA_WIDTH (AXI_DATA_W),
        .ADDR_WIDTH (AXI_ADDR_W),
        .ID_WIDTH   (AXI_ID_W)
    ) u_axi_dma_bridge (
        .clk            (clk),
        .rst_n          (rst_n),
        // Slave 0: BSR DMA
        .s0_arid        (bsr_arid),
        .s0_araddr      (bsr_araddr),
        .s0_arlen       (bsr_arlen),
        .s0_arsize      (bsr_arsize),
        .s0_arburst     (bsr_arburst),
        .s0_arvalid     (bsr_arvalid),
        .s0_arready     (bsr_arready),
        .s0_rid         (bsr_rid),
        .s0_rdata       (bsr_rdata),
        .s0_rresp       (bsr_rresp),
        .s0_rlast       (bsr_rlast),
        .s0_rvalid      (bsr_rvalid),
        .s0_rready      (bsr_rready),
        // Slave 1: Activation DMA
        .s1_arid        (act_arid),
        .s1_araddr      (act_araddr),
        .s1_arlen       (act_arlen),
        .s1_arsize      (act_arsize),
        .s1_arburst     (act_arburst),
        .s1_arvalid     (act_arvalid),
        .s1_arready     (act_arready),
        .s1_rid         (act_rid),
        .s1_rdata       (act_rdata),
        .s1_rresp       (act_rresp),
        .s1_rlast       (act_rlast),
        .s1_rvalid      (act_rvalid),
        .s1_rready       (act_rready),
        // Master to DDR
        .m_arid         (m_axi_arid),
        .m_araddr       (m_axi_araddr),
        .m_arlen        (m_axi_arlen),
        .m_arsize       (m_axi_arsize),
        .m_arburst      (m_axi_arburst),
        .m_arvalid      (m_axi_arvalid),
        .m_arready      (m_axi_arready),
        .m_rid          (m_axi_rid),
        .m_rdata        (m_axi_rdata),
        .m_rresp        (m_axi_rresp),
        .m_rlast        (m_axi_rlast),
        .m_rvalid       (m_axi_rvalid),
        .m_rready       (m_axi_rready)
    );

    // -------------------------------------------------------------------------
    // 4. Activation DMA (Loads Dense Activations from DDR → act_buffer)
    // -------------------------------------------------------------------------
    // Performs burst reads from DDR to load activation vectors.
    // Activations are stored as contiguous INT8 arrays in row-major order.
    //
    // Transfer Flow:
    //   1. Host writes cfg_act_src_addr (DDR address) and cfg_act_xfer_len
    //   2. Host pulses cfg_act_dma_start
    //   3. DMA issues 16-beat bursts until xfer_len bytes transferred
    //   4. DMA asserts act_dma_done when complete
    //
    // STREAM_ID = 1: Distinguishes from BSR DMA in AXI ID field for debugging
    // BURST_LEN = 15: 16 beats × 8 bytes = 128 bytes per burst
    act_dma #(
        .AXI_ADDR_W (AXI_ADDR_W),
        .AXI_DATA_W (AXI_DATA_W),
        .AXI_ID_W   (AXI_ID_W),
        .STREAM_ID  (1),            // ID = 1 for Act DMA (s1 of bridge)
        .BURST_LEN  (8'd15)         // 16-beat bursts (128 bytes)
    ) u_act_dma (
        .clk                (clk),
        .rst_n              (rst_n),
        // Control
        .start              (act_dma_start),
        .src_addr           (act_dma_src_addr),
        .transfer_length    (act_dma_xfer_len),
        .done               (act_dma_done),
        .busy               (act_dma_busy),
        .error              (act_dma_error),
        // AXI Master (to Bridge)
        .m_axi_arid         (act_arid),
        .m_axi_araddr       (act_araddr),
        .m_axi_arlen        (act_arlen),
        .m_axi_arsize       (act_arsize),
        .m_axi_arburst      (act_arburst),
        .m_axi_arvalid      (act_arvalid),
        .m_axi_arready      (act_arready),
        .m_axi_rid          (act_rid),
        .m_axi_rdata        (act_rdata),
        .m_axi_rresp        (act_rresp),
        .m_axi_rlast        (act_rlast),
        .m_axi_rvalid       (act_rvalid),
        .m_axi_rready       (act_rready),
        // Buffer Write Interface
        .act_we             (act_buf_we),
        .act_addr           (_unused_act_waddr),
        .act_wdata          (act_buf_wdata)
    );

    // -------------------------------------------------------------------------
    // 5. BSR DMA (Loads Sparse Weights from DDR → Metadata BRAMs)
    // -------------------------------------------------------------------------
    // Parses BSR (Block Sparse Row) format and populates three BRAMs:
    //   1. row_ptr_bram: CSR-style row pointers (32-bit each)
    //   2. col_idx_bram: Column indices of non-zero blocks (16-bit each)
    //   3. wgt_block_bram: Weight data for non-zero blocks (16×16 INT8 each)
    //
    // BSR Format in DDR (see docs/architecture/SPARSITY_FORMAT.md):
    //   Offset 0x00: num_rows (32-bit)
    //   Offset 0x04: num_cols (32-bit)
    //   Offset 0x08: nnz_blocks (32-bit)
    //   Offset 0x0C: block_size (32-bit, always 16 for this design)
    //   Offset 0x10: row_ptr[0..num_rows] (num_rows+1 × 32-bit)
    //   After row_ptr: col_idx[0..nnz_blocks-1] (nnz_blocks × 16-bit)
    //   After col_idx (aligned): blocks[0..nnz_blocks-1] (nnz_blocks × 256 bytes)
    //
    // STREAM_ID = 0: Primary DMA, checked first in bridge arbiter
    bsr_dma #(
        .AXI_ADDR_W  (AXI_ADDR_W),
        .AXI_DATA_W  (AXI_DATA_W),
        .AXI_ID_W    (AXI_ID_W),
        .STREAM_ID   (0),           // ID = 0 for BSR DMA (s0 of bridge)
        .BRAM_ADDR_W (BRAM_ADDR_W),
        .BURST_LEN   (8'd15)        // 16-beat bursts
    ) u_bsr_dma (
        .clk                (clk),
        .rst_n              (rst_n),
        // Control
        .start              (bsr_dma_start),
        .src_addr           (bsr_dma_src_addr),
        // CSR inputs for BSR dimensions (driver-provided)
        .csr_num_rows       (cfg_bsr_block_rows),
        .csr_total_blocks   (cfg_bsr_num_blocks),
        .done               (bsr_dma_done),
        .busy               (bsr_dma_busy),
        .error              (bsr_dma_error),
        // AXI Master (to Bridge)
        .m_axi_arid         (bsr_arid),
        .m_axi_araddr       (bsr_araddr),
        .m_axi_arlen        (bsr_arlen),
        .m_axi_arsize       (bsr_arsize),
        .m_axi_arburst      (bsr_arburst),
        .m_axi_arvalid      (bsr_arvalid),
        .m_axi_arready      (bsr_arready),
        .m_axi_rid          (bsr_rid),
        .m_axi_rdata        (bsr_rdata),
        .m_axi_rresp        (bsr_rresp),
        .m_axi_rlast        (bsr_rlast),
        .m_axi_rvalid       (bsr_rvalid),
        .m_axi_rready       (bsr_rready),
        // BRAM Write Interfaces
        .row_ptr_we         (row_ptr_we),
        .row_ptr_addr       (row_ptr_waddr),
        .row_ptr_wdata      (row_ptr_wdata),
        .col_idx_we         (col_idx_we),
        .col_idx_addr       (col_idx_waddr),
        .col_idx_wdata      (col_idx_wdata),
        .wgt_we             (wgt_we),
        .wgt_addr           (_unused_wgt_waddr),
        .wgt_wdata          (wgt_wdata)
    );

    // -------------------------------------------------------------------------
    // 6. BSR Metadata SRAM Wrappers
    // -------------------------------------------------------------------------
    // These tables now sit behind technology-neutral synchronous SRAM wrappers.
    // The wrapper is the future macro binding point for ASIC flows.
    //
    // Memory Sizing:
    //   - row_ptr_bram: 1024 × 32-bit = 32Kb → 1× RAMB36 or 2× RAMB18
    //   - col_idx_bram: 1024 × 16-bit = 16Kb → 1× RAMB18
    //   - wgt_block_bram: 1024 × 64-bit = 64Kb → 2× RAMB36
    //   Total: ~112Kb (~3-4 BRAM36 equivalent)
    //
    // Timing:
    //   - Write: Captured on rising edge when *_we=1
    //   - Read: 1-cycle synchronous latency through the wrapper
    
    // -------------------------------------------------------------------------
    // 6a. Row Pointer BRAM (32-bit entries, CSR format)
    // -------------------------------------------------------------------------
    // row_ptr[i] = index of first non-zero block in row i
    // row_ptr[num_rows] = total number of non-zero blocks
    wire                   row_ptr_mem_en   = row_ptr_we || sched_row_ptr_rd_en;
    wire [BRAM_ADDR_W-1:0] row_ptr_mem_addr = row_ptr_we ? row_ptr_waddr : sched_row_ptr_addr;

    sram_1rw_wrapper #(
        .DATA_W (32),
        .ADDR_W (BRAM_ADDR_W),
        .DEPTH  (1 << BRAM_ADDR_W)
    ) u_row_ptr_mem (
        .clk   (clk),
        .rst_n (rst_n),
        .en    (row_ptr_mem_en),
        .we    (row_ptr_we),
        .addr  (row_ptr_mem_addr),
        .wdata (row_ptr_wdata),
        .rdata (sched_row_ptr_data)
    );

    // -------------------------------------------------------------------------
    // 6b. Column Index BRAM (16-bit entries)
    // -------------------------------------------------------------------------
    // col_idx[j] = column block index for j-th non-zero block
    // Used by scheduler to compute activation address offset
    wire                   col_idx_mem_en   = col_idx_we || sched_col_idx_rd_en;
    wire [BRAM_ADDR_W-1:0] col_idx_mem_addr = col_idx_we ? col_idx_waddr : sched_col_idx_addr;

    sram_1rw_wrapper #(
        .DATA_W (16),
        .ADDR_W (BRAM_ADDR_W),
        .DEPTH  (1 << BRAM_ADDR_W)
    ) u_col_idx_mem (
        .clk   (clk),
        .rst_n (rst_n),
        .en    (col_idx_mem_en),
        .we    (col_idx_we),
        .addr  (col_idx_mem_addr),
        .wdata (col_idx_wdata),
        .rdata (sched_col_idx_data)
    );

    always @(posedge clk) begin
        if (row_ptr_we && sched_row_ptr_rd_en)
            $error("accel_top: simultaneous row_ptr write/read to single-port metadata SRAM");
        if (col_idx_we && sched_col_idx_rd_en)
            $error("accel_top: simultaneous col_idx write/read to single-port metadata SRAM");
    end

    // -------------------------------------------------------------------------
    // 6c. Weight Block BRAM (128-bit entries, with DMA packer)
    // -------------------------------------------------------------------------
    // DMA writes 64-bit beats → dma_pack_112 packs to 128-bit → wgt_bram stores.
    // Scheduler reads 128-bit rows (16 × INT8 = one row of a 16×16 weight block).
    //
    // Each block = 16 rows × 16 cols = 256 INT8 values.
    // Address from scheduler: {block_idx, row_within_block}
    wire                          wgt_pack_we;
    wire [BRAM_ADDR_W-1:0]        wgt_pack_waddr;
    wire [N_COLS*DATA_W-1:0]      wgt_pack_wdata;  // 128 bits

    dma_pack_112 #(
        .OUT_W  (N_COLS * DATA_W),   // 128
        .ADDR_W (BRAM_ADDR_W)        // 10
    ) u_wgt_packer (
        .clk        (clk),
        .rst_n      (rst_n),
        .dma_we     (wgt_we),
        .dma_wdata  (wgt_wdata),
        .buf_we     (wgt_pack_we),
        .buf_waddr  (wgt_pack_waddr),
        .buf_wdata  (wgt_pack_wdata)
    );

    // -------------------------------------------------------------------------
    // 6d. Weight Double-Buffer (Ping-Pong Banks via wgt_buffer.sv)
    // -------------------------------------------------------------------------
    // Although weights load once per layer, double-buffering allows:
    // - Prefetching next layer's weights during current layer compute
    // - Consistent architecture with act_buffer
    // - Future support for layer pipelining
    
    // Edge detector: create single-cycle pulse from sched_done rising edge
    // (Defined here as it's needed by both wgt_buffer and act_buffer)
    reg sched_done_d1;
    always @(posedge clk or negedge rst_n) begin
        if (!rst_n) sched_done_d1 <= 1'b0;
        else        sched_done_d1 <= sched_done;
    end
    wire sched_done_pulse = sched_done & ~sched_done_d1;
    
    // Weight bank selection (same toggle as activation for simplicity)
    reg wgt_bank_sel;
    
    always @(posedge clk or negedge rst_n) begin
        if (!rst_n)
            wgt_bank_sel <= 1'b0;
        else if (start_pulse || sched_done_pulse)
            wgt_bank_sel <= ~wgt_bank_sel;
    end

    wire [N_COLS*DATA_W-1:0] wgt_block_rdata_r;  // Output from wgt_buffer
    
    wgt_buffer #(
        .TN         (N_COLS),       // 16 columns
        .ADDR_WIDTH (BRAM_ADDR_W)   // 10 bits = 1024 depth
    ) u_wgt_buffer (
        .clk         (clk),
        .rst_n       (rst_n),
        
        // DMA Write Port (writes to BACKGROUND bank for true double-buffering)
        .we          (wgt_pack_we),
        .waddr       (wgt_pack_waddr),
        .wdata       (wgt_pack_wdata),
        .bank_sel_wr (~wgt_bank_sel),  // Write to BACKGROUND bank (opposite of compute)
        
        // Systolic Array Read Port (reads from active bank)
        .rd_en       (1'b1),           // Always enabled when computing
        .k_idx       (wgt_rd_addr[BRAM_ADDR_W-1:0]),
        .bank_sel_rd (wgt_bank_sel),   // Compute reads from the ACTIVE bank
        .b_vec       (wgt_block_rdata_r)
    );

    // (Section 7 removed — meta decoder replaced by direct BRAM wires above)

    // -------------------------------------------------------------------------
    // 8. BSR Scheduler (Traverses Sparse Blocks — sole scheduler)
    // -------------------------------------------------------------------------
    // Iterates through the BSR structure and generates control signals for
    // the systolic array. Implements weight-stationary dataflow:
    //
    // For each block row (m_tile = 0 to MT-1):
    //   ptr_start = row_ptr[m_tile]
    //   ptr_end   = row_ptr[m_tile + 1]
    //   For each non-zero block (blk = ptr_start to ptr_end-1):
    //     col = col_idx[blk]
    //     1. Load weight block[blk] into systolic array (load_weight=1)
    //     2. Stream 14 activation rows (pe_en=1)
    //     3. Accumulate results (accum_en=1)
    //   End block loop (results stay in accumulators)
    // End row loop → done
    //
    // BLOCK_SIZE must match systolic array dimensions (N_ROWS = N_COLS = 16).
    bsr_scheduler #(
        .M_W         (10),           // Tile row index width (up to 1023 rows)
        .K_W         (12),           // Tile K index width (up to 4095 cols)
        .ADDR_W      (AXI_ADDR_W),   // Address width for buffer access
        .BRAM_ADDR_W (BRAM_ADDR_W),  // BRAM address width
        .BLOCK_SIZE  (N_ROWS)        // Block size = systolic array dimension
    ) u_bsr_scheduler (
        .clk            (clk),
        .rst_n          (rst_n),
        // Control
        .start          (sched_start),
        .abort          (abort_pulse),
        .busy           (sched_busy),
        .done           (sched_done),
        // Configuration
        .MT             (sched_MT),
        .KT             (sched_KT),
        // Direct BRAM reads (no meta decoder)
        .row_ptr_rd_en   (sched_row_ptr_rd_en),
        .row_ptr_rd_addr (sched_row_ptr_addr),
        .row_ptr_rd_data (sched_row_ptr_data),
        .col_idx_rd_en   (sched_col_idx_rd_en),
        .col_idx_rd_addr (sched_col_idx_addr),
        .col_idx_rd_data (sched_col_idx_data),
        // Buffer Interfaces
        .wgt_rd_en      (_unused_wgt_rd_en),
        .wgt_addr       (wgt_rd_addr),
        .act_rd_en      (act_rd_en),
        .act_addr       (act_rd_addr),
        // Systolic Control
        .load_weight    (load_weight),
        .pe_en          (pe_en),
        .accum_en       (_unused_accum_en),
        .pe_clr         (pe_clr)
    );

    // NOTE: Dense scheduler removed — BSR-only architecture.
    // All systolic control signals come directly from u_bsr_scheduler above.

    // -------------------------------------------------------------------------
    // 9. Activation Buffer (Double-Buffered via act_buffer.sv)
    // -------------------------------------------------------------------------
    // PING-PONG DOUBLE BUFFERING:
    // - DMA writes to "background" bank while compute reads "active" bank
    // - Banks swap when scheduler completes a tile (sched_done_pulse)
    // - Eliminates stalls: DMA and compute overlap 100%
    
    // Bank selection register (0 = compute reads Bank0, 1 = compute reads Bank1)
    reg act_bank_sel;

    // Flip the bank when compute finishes (swap active/background)
    // (sched_done_pulse is defined in Section 6d above)
    always @(posedge clk or negedge rst_n) begin
        if (!rst_n)
            act_bank_sel <= 1'b0;
        else if (start_pulse || sched_done_pulse)
            act_bank_sel <= ~act_bank_sel;
    end

    // -------------------------------------------------------------------------
    // 9a. Activation DMA Packer (64-bit AXI → 128-bit BRAM width)
    // -------------------------------------------------------------------------
    // Packs two 64-bit DMA beats into one 128-bit (16 × INT8) BRAM write.
    // Address auto-increments after each packed write.
    wire                          act_pack_we;
    wire [BRAM_ADDR_W-1:0]        act_pack_waddr;
    wire [N_ROWS*DATA_W-1:0]      act_pack_wdata;  // 128 bits

    dma_pack_112 #(
        .OUT_W  (N_ROWS * DATA_W),   // 128
        .ADDR_W (BRAM_ADDR_W)        // 10
    ) u_act_packer (
        .clk        (clk),
        .rst_n      (rst_n),
        .dma_we     (act_buf_we),
        .dma_wdata  (act_buf_wdata),
        .buf_we     (act_pack_we),
        .buf_waddr  (act_pack_waddr),
        .buf_wdata  (act_pack_wdata)
    );

    // -------------------------------------------------------------------------
    // 9b. Feedback Packer (64-bit BRAM reads → 128-bit act_buffer words)
    // -------------------------------------------------------------------------
    // output_bram_ctrl reads 64-bit words from BRAM during feedback. These
    // must be repacked to 128-bit (16 × INT8) before writing to act_buffer.
    wire                          fb_pack_we;
    wire [BRAM_ADDR_W-1:0]        fb_pack_waddr;
    wire [N_ROWS*DATA_W-1:0]      fb_pack_wdata;  // 128 bits

    dma_pack_112 #(
        .OUT_W  (N_ROWS * DATA_W),   // 128
        .ADDR_W (BRAM_ADDR_W)        // 10
    ) u_fb_packer (
        .clk        (clk),
        .rst_n      (rst_n),
        .dma_we     (obram_ctrl_fb_we),
        .dma_wdata  (obram_ctrl_fb_wdata[63:0]),  // Lower 64 bits from ctrl
        .buf_we     (fb_pack_we),
        .buf_waddr  (fb_pack_waddr),
        .buf_wdata  (fb_pack_wdata)
    );

    // -------------------------------------------------------------------------
    // 9b-ii. Feedback MUX (DMA packer vs feedback packer → act_buffer)
    // -------------------------------------------------------------------------
    // When feedback_busy, the repacked feedback data writes to act_buffer.
    // Otherwise, the act_dma packer writes from DDR.
    assign fb_mux_act_we    = obram_ctrl_feedback_busy ? fb_pack_we    : act_pack_we;
    assign fb_mux_act_waddr = obram_ctrl_feedback_busy ? fb_pack_waddr : act_pack_waddr;
    assign fb_mux_act_wdata = obram_ctrl_feedback_busy ? fb_pack_wdata : act_pack_wdata;

    // -------------------------------------------------------------------------
    // 9c. Activation Double-Buffer Memory (Ping-Pong Banks)
    // -------------------------------------------------------------------------
    act_buffer #(
        .TM         (N_ROWS),       // 16 rows
        .ADDR_WIDTH (BRAM_ADDR_W)   // 10 bits = 1024 depth
    ) u_act_buffer (
        .clk         (clk),
        .rst_n       (rst_n),
        
        // Write Port: feedback MUX (DMA packer or BRAM ctrl feedback)
        .we          (fb_mux_act_we),
        .waddr       (fb_mux_act_waddr),
        .wdata       (fb_mux_act_wdata),
        .bank_sel_wr (~act_bank_sel),  // Write to BACKGROUND bank (opposite of compute)
        
        // Systolic Array Read Port (reads from active bank)
        .rd_en       (act_rd_en),
        .k_idx       (act_rd_addr[BRAM_ADDR_W-1:0]),
        .bank_sel_rd (act_bank_sel),   // Compute reads from the ACTIVE bank
        .a_vec       (act_rd_data)
    );

    // -------------------------------------------------------------------------
    // 10. Weight Read Path (Block data from wgt_block_bram)
    // -------------------------------------------------------------------------
    // One row of weights (16 INT8 values = 128 bits) per BRAM entry.
    // BRAM width now matches systolic array input width.
    assign wgt_rd_data = wgt_block_rdata_r[N_COLS*DATA_W-1:0];

    // -------------------------------------------------------------------------
    // 11. Sparse Systolic Array (2D PE Array with Skip-Zero Logic)
    // -------------------------------------------------------------------------
    // Core compute unit: 16×16 grid of Processing Elements (PEs).
    // Each PE performs: acc[i][j] += a[i] × w[j]
    //
    // Weight-Stationary Dataflow:
    //   1. Weights loaded once per block (load_weight=1)
    //   2. Activations streamed through (pe_en=1 for 14 cycles)
    //   3. Results accumulate across K dimension
    //
    // Sparse Optimization:
    //   - Zero blocks are skipped entirely (no MAC cycles)
    //
    // Resource Usage: 256 DSP48E1 slices (one per PE)
    systolic_array_sparse #(
        .N_ROWS (N_ROWS),           // 16 rows
        .N_COLS (N_COLS),           // 16 columns
        .DATA_W (DATA_W),           // 8-bit inputs
        .ACC_W  (ACC_W)             // 32-bit accumulators
    ) u_systolic_sparse (
        .clk            (clk),
        .rst_n          (rst_n),
        .clk_en         (1'b1),
        // Control
        .block_valid    (pe_en),            // Enable MAC operations
        .load_weight    (load_weight),      // Load weights into PE registers
        .clr            (pe_clr),           // Clear accumulators (on abort)
        // Data
        .a_in_flat      (act_rd_data),      // 16 × 8-bit activations
        .b_in_flat      (wgt_rd_data),      // 16 × 8-bit weights
        // Output
        .c_out_flat     (systolic_out_flat) // 256 × 32-bit accumulators
    );

    // -------------------------------------------------------------------------
    // 12. Row Completion Detection (BSR → Output Accumulator Timing)
    // -------------------------------------------------------------------------
    // PEs have clr=0 internally, so accumulators persist across all blocks
    // within the computation. The full result is available only when
    // sched_done fires (all k-rows processed).
    // row_complete_d1 provides a 1-cycle delayed clear for the new active bank.
    always @(posedge clk or negedge rst_n) begin
        if (!rst_n)
            row_complete_d1 <= 1'b0;
        else
            row_complete_d1 <= row_complete;
    end

    assign row_complete = sched_done;

    // -------------------------------------------------------------------------
    // 13. Output Accumulator (ReLU + INT32->INT8 Quantization)
    // -----------------------------------------------------------------
    // Captures systolic results, applies optional ReLU + Q16.16 scaling
    // to quantize INT32 accumulators down to INT8 for the next layer.
    //
    // BSR Timing:
    //   - acc_valid  = row_complete   (one-shot latch: 0 + sys_out = sys_out)
    //   - acc_clear  = row_complete_d1 (clear NEW active bank 1 cycle later)
    //   - tile_done  = row_complete   (swap banks for DMA readback)
    //
    // DMA read interface is exposed for future write-DMA to DDR.
    // For now, results are also readable via CSR result_data registers.
    //output_accumulator #(’s results
    // -------------------------------------------------------------------------
    // 13. Output Accumulator (ReLU → last row’s results available.
    //
    // -------------------------------------------------------------------------
    // -------------------------------------------------------------------------
    // Captures the systolic array’
    output_accumulator #(
        .N_ROWS (N_ROWS),
        .N_COLS (N_COLS),
        .ACC_W  (ACC_W),
        .OUT_W  (8),
        .ADDR_W (BRAM_ADDR_W)
    ) u_output_accum (
        .clk            (clk),
        .rst_n          (rst_n),
        // Control
        .acc_valid      (row_complete),         // Latch systolic output (once per row)
        .acc_clear      (row_complete_d1),      // Clear new active bank for next row
        .tile_done      (row_complete),         // Swap banks (DMA reads completed row)
        .relu_en        (cfg_bsr_config[1]),    // BSR_CONFIG bit 1 = ReLU enable
        .scale_factor   (cfg_sa_bits),          // Q16.16 scale from CSR
        // Systolic Array Input
        .systolic_out   (systolic_out_flat),    // 256 × INT32 accumulators
        // DMA Read Interface (connected to output_bram_ctrl, not out_dma directly)
        .dma_rd_en      (mux_accum_rd_en),
        .dma_rd_addr    (mux_accum_rd_addr),
        .dma_rd_data    (out_dma_rd_data),
        .dma_ready      (out_dma_ready),
        // Status
        .busy           (accum_busy),
        .bank_sel       (accum_bank_sel),
        .acc_debug      (_unused_accum_debug)
    );

    // -------------------------------------------------------------------------
    // 14a-i. Max Pool 2×2 (Bypassable — Between Ctrl and BRAM)
    // -------------------------------------------------------------------------
    // When pool_en=1 (CNN layers), applies 2×2 max pooling to the data
    // flowing from output_bram_ctrl → BRAM. When pool_en=0 (FC layers),
    // bypasses and passes data through unchanged.
    //
    // The ctrl writes data as if there's no pooler (sequential addresses).
    // We intercept those writes, run them through the pooler, and use a
    // separate address counter for the actual BRAM writes.
    max_pool_2x2 #(
        .DATA_W  (8),
        .MAX_W   (128),
        .PACK_W  (64)
    ) u_max_pool (
        .clk        (clk),
        .rst_n      (rst_n),
        .bypass     (~cfg_pool_en),     // Bypass when pooling disabled
        .feat_h     (cfg_output_h),     // Pre-pool feature map height
        .feat_w     (cfg_output_w),     // Pre-pool feature map width
        .in_valid   (obram_ctrl_bram_wr_en),
        .in_data    (obram_ctrl_bram_wr_data),
        .in_ready   (pool_in_ready),
        .out_valid  (pool_out_valid),
        .out_data   (pool_out_data),
        .out_ready  (1'b1),             // BRAM always accepts
        .pool_active()
    );

    // Post-pooler BRAM write address counter
    // Resets when ctrl starts a new capture, increments on each pooler output
    always @(posedge clk or negedge rst_n) begin
        if (!rst_n)
            pool_bram_wr_addr <= {BRAM_ADDR_W{1'b0}};
        else if (sched_done_pulse)
            pool_bram_wr_addr <= {BRAM_ADDR_W{1'b0}};  // Reset on new layer
        else if (pool_out_valid)
            pool_bram_wr_addr <= pool_bram_wr_addr + {{(BRAM_ADDR_W-1){1'b0}}, 1'b1};
    end

    // -------------------------------------------------------------------------
    // 14a-ii. Output BRAM Buffer (Double-Buffered Inter-Layer Storage)
    // -------------------------------------------------------------------------
    // Stores quantized INT8 output between layers. Two 8KB banks for
    // ping-pong: one bank receives current layer output while other
    // feeds activations back or drains to DDR.
    // Write port fed from pooler output (bypass mode when no pooling).
    output_bram_buffer #(
        .DATA_W (64),
        .ADDR_W (BRAM_ADDR_W),
        .DEPTH  (1 << BRAM_ADDR_W)
    ) u_output_bram (
        .clk        (clk),
        .rst_n      (rst_n),
        .bank_sel   (obram_ctrl_bank_sel),
        .wr_en      (pool_out_valid),          // Pooler output drives BRAM write
        .wr_addr    (pool_bram_wr_addr),       // Post-pooler address counter
        .wr_data    (pool_out_data),            // Pooled (or bypassed) data
        .rd_en      (obram_ctrl_bram_rd_en | out_dma_rd_en),
        .rd_addr    (obram_ctrl_bram_rd_en ? obram_ctrl_bram_rd_addr : out_dma_rd_addr),
        .rd_data    (obram_bram_rd_data),
        .rd_valid   (obram_bram_rd_valid)
    );

    // -------------------------------------------------------------------------
    // 14b. Output BRAM Controller (Multi-Layer FSM)
    // -------------------------------------------------------------------------
    // Captures accumulator output → BRAM, then routes to feedback or DDR.
    output_bram_ctrl #(
        .DATA_W     (64),
        .ADDR_W     (BRAM_ADDR_W),
        .ACT_ADDR_W (BRAM_ADDR_W),
        .ACT_DATA_W (N_ROWS * DATA_W),  // 128 bits
        .NUM_ACCS   (N_ROWS * N_COLS)   // 256
    ) u_obram_ctrl (
        .clk            (clk),
        .rst_n          (rst_n),
        // Layer configuration
        .layer_total    (cfg_layer_total),
        .layer_current  (cfg_layer_current),
        .pool_en        (cfg_pool_en),
        .output_h       (cfg_output_h),
        .output_w       (cfg_output_w),
        // Accumulator read (captures quantized output)
        .accum_rd_en    (obram_ctrl_accum_rd_en),
        .accum_rd_addr  (obram_ctrl_accum_rd_addr),
        .accum_rd_data  (out_dma_rd_data),
        .accum_ready    (out_dma_ready),
        // BRAM write
        .bram_wr_en     (obram_ctrl_bram_wr_en),
        .bram_wr_addr   (obram_ctrl_bram_wr_addr),
        .bram_wr_data   (obram_ctrl_bram_wr_data),
        .bram_bank_sel  (obram_ctrl_bank_sel),
        // BRAM read (for feedback)
        .bram_rd_en     (obram_ctrl_bram_rd_en),
        .bram_rd_addr   (obram_ctrl_bram_rd_addr),
        .bram_rd_data   (obram_bram_rd_data),
        .bram_rd_valid  (obram_bram_rd_valid),
        // Feedback → act_buffer
        .fb_act_we      (obram_ctrl_fb_we),
        .fb_act_waddr   (obram_ctrl_fb_waddr),
        .fb_act_wdata   (obram_ctrl_fb_wdata),
        // Control
        .sched_done     (sched_done),
        .start          (start_pulse),
        // Out DMA control (last layer)
        .out_dma_trigger(obram_ctrl_out_dma_trigger),
        .out_dma_done   (out_dma_done),
        // Status
        .layer_done     (obram_ctrl_layer_done),
        .last_layer_done(obram_ctrl_last_layer_done),
        .feedback_busy  (obram_ctrl_feedback_busy),
        .busy           (obram_ctrl_busy)
    );

    // -------------------------------------------------------------------------
    // 14c. Output Write DMA (Drains BRAM → DDR via AXI4 Write)
    // -------------------------------------------------------------------------
    // Triggered by output_bram_ctrl on LAST LAYER only.
    // Reads quantized INT8 results from BRAM buffer (not accumulator directly)
    // and writes them to DDR at cfg_dma_dst_addr.
    //
    // If cfg_dma_dst_addr == 0, the output DMA immediately signals done,
    // preserving the CSR-based readback path.
    out_dma #(
        .AXI_ADDR_W  (AXI_ADDR_W),
        .AXI_DATA_W  (AXI_DATA_W),
        .AXI_ID_W    (AXI_ID_W),
        .BRAM_ADDR_W (BRAM_ADDR_W),
        .NUM_ACCS    (N_ROWS * N_COLS),   // 256
        .STREAM_ID   (2)                  // ID=2 for output writes
    ) u_out_dma (
        .clk            (clk),
        .rst_n          (rst_n),
        // Control
        .start          (obram_ctrl_out_dma_trigger),  // Triggered by BRAM ctrl on last layer
        .dst_addr       (cfg_dma_dst_addr),
        .done           (out_dma_done),
        .busy           (out_dma_busy),
        // BRAM Read Interface (reads from output BRAM, not accumulator directly)
        .accum_rd_en    (out_dma_rd_en),
        .accum_rd_addr  (out_dma_rd_addr),
        .accum_rd_data  (obram_bram_rd_data),  // Data from BRAM buffer
        .accum_ready    (1'b1),                // BRAM always ready when ctrl triggers DMA
        // AXI4 Write (direct to top-level, no arbitration)
        .m_axi_awid     (m_axi_awid),
        .m_axi_awaddr   (m_axi_awaddr),
        .m_axi_awlen    (m_axi_awlen),
        .m_axi_awsize   (m_axi_awsize),
        .m_axi_awburst  (m_axi_awburst),
        .m_axi_awvalid  (m_axi_awvalid),
        .m_axi_awready  (m_axi_awready),
        .m_axi_wdata    (m_axi_wdata),
        .m_axi_wstrb    (m_axi_wstrb),
        .m_axi_wlast    (m_axi_wlast),
        .m_axi_wvalid   (m_axi_wvalid),
        .m_axi_wready   (m_axi_wready),
        .m_axi_bid      (m_axi_bid),
        .m_axi_bresp    (m_axi_bresp),
        .m_axi_bvalid   (m_axi_bvalid),
        .m_axi_bready   (m_axi_bready)
    );

    // -------------------------------------------------------------------------
    // 15. Performance Monitor
    // -------------------------------------------------------------------------
    // Tracks execution cycles for profiling and optimization.
    //
    // Counters:
    //   - total_cycles:      Cycles from start_pulse to sched_done
    //   - active_cycles:     Cycles with busy=1 (actual computation)
    //   - idle_cycles:       Cycles waiting for memory/stalls
    //   - dma_bytes:         Total bytes transferred by both DMAs
    //   - blocks_processed:  Non-zero BSR blocks computed
    //   - stall_cycles:      Scheduler busy but PEs idle (metadata latency)
    //
    // These counters are readable via CSR PERF_* registers.
    // Host can compute:
    //   - Utilization = active_cycles / total_cycles
    //   - Throughput = (M * K * 2) / total_cycles ops/cycle
    perf #(
        .COUNTER_WIDTH(32)          // 32-bit counters (43 sec @ 100 MHz)
    ) u_perf (
        .clk                    (clk),
        .rst_n                  (rst_n),
        // Control
        .start_pulse            (start_pulse),  // Begin measurement
        .done_pulse             (sched_done),   // End measurement
        .busy_signal            (busy),         // Active computation
        // Real-time counter inputs
        .pe_en_signal           (pe_en),        // PE active (for stall detection)
        .sched_busy_signal      (sched_busy),   // Scheduler busy (for stall detection)
        .dma_beat_valid         (m_axi_rvalid & m_axi_rready), // AXI beat accepted
        .block_done_pulse       (load_weight),   // Block completion (TODO: per-block pulse)
        // Outputs (to CSR)
        .total_cycles_count     (perf_total_cycles),
        .active_cycles_count    (perf_active_cycles),
        .idle_cycles_count      (perf_idle_cycles),
        .dma_bytes_count        (perf_dma_bytes),
        .blocks_processed_count (perf_blocks_processed),
        .stall_cycles_count     (perf_stall_cycles),
        .measurement_done       (_unused_perf_done)
    );

    // =========================================================================
    // DEBUG: Trace output path signals during simulation
    // =========================================================================
    // synthesis translate_off
    always @(posedge clk) begin
        if (sched_done)
            $display("[ACCEL_TOP] sched_done=1  @ %0t", $time);
        if (row_complete)
            $display("[ACCEL_TOP] row_complete=1  systolic_out[0]=%0d  @ %0t",
                     $signed(systolic_out_flat[31:0]), $time);
        if (load_weight)
            $display("[ACCEL_TOP] load_weight=1  wgt_rd_data[7:0]=%0d  @ %0t",
                     $signed(wgt_rd_data[7:0]), $time);
        if (pe_en && !$past(pe_en))
            $display("[ACCEL_TOP] pe_en RISING  act[7:0]=%0d wgt[7:0]=%0d  @ %0t",
                     $signed(act_rd_data[7:0]), $signed(wgt_rd_data[7:0]), $time);
        if (pe_en && $past(pe_en) && ($time - 1670000) < 50000)
            $display("[ACCEL_TOP] pe_en cycle  act[7:0]=%0d  @ %0t",
                     $signed(act_rd_data[7:0]), $time);
        if (!pe_en && $past(pe_en))
            $display("[ACCEL_TOP] pe_en FALLING  @ %0t", $time);
        if (obram_ctrl_out_dma_trigger)
            $display("[ACCEL_TOP] out_dma_trigger=1  @ %0t", $time);
        if (out_dma_done)
            $display("[ACCEL_TOP] out_dma_done=1  @ %0t", $time);
        if (obram_ctrl_last_layer_done)
            $display("[ACCEL_TOP] last_layer_done=1  @ %0t", $time);
        if (done)
            $display("[ACCEL_TOP] *** DONE=1 ***  @ %0t", $time);
    end
    // synthesis translate_on


endmodule

`default_nettype wire
